minhtenlado/IoT_Gateway_STM32F407VGTx/production/bom.csv

Designator | Footprint | Quantity | Value | LCSC Part #
BT1 | BatteryHolder_Keystone_3034_1x20mm | 1 | Battery_Cell
C1, C12, C14, C15, C16, C17, C18, C19, C20, C21, C22, C25, C26, C32, C33, C36, C37, C4, C41, C42, C5, C6, C7 | 0603 | 23 | 100nF
C10, C11 | 0603 | 2 | 2.2uF
C13, C27, C62 | 0603 | 3 | 1uF
C2, C3 | 0603 | 2 | 20pF
C23, C8, C9 | 0603 | 3 | 10uF
C24 | 0603 | 1 | 470pF
C28 | 0603 | 1 | 4.7uF
C29, C30 | 0603 | 2 | 15pF
C31 | 0603 | 1 | 22nF
C34 | 0603 | 1 | 1nF
C35 | 1210 | 1 | 10uF
C38, C43, C44, C45 | 1210 | 4 | 22uF
C39 | 0805 | 1 | 10uF
C40, C59 | CP_Radial_D6.3mm_P2.50mm | 2 | 47uF
C46, C49, C50, C52, C56, C57, C58, C61 | 0805 | 8 | 100nF
C47, C51 | 1206 | 2 | 10uF
C48, C53, C60 | 0805 | 3 | 1uF
C54 | 0603 | 1 | 8.2pF
C55 | 0805 | 1 | 8.2pF
D1 | 0603 | 1 | RED
D10, D11, D8, D9 | 0805 | 4 | LED
D12 | 0805 | 1 | LED Green
D13 | 0805 | 1 | LED Red
D2 | 0603 | 1 | BLUE
D3, D4 | D_SMA | 2 | SS14
D5 | D_SMA | 1 | SS34
D6 | D_SMB | 1 | SMBJ15CA
D7 | D_SOD-323 | 1 | BAS116WS
F1 | 1206 | 1 | 2A Slow-Blow
FB1, FB2 | 0603 | 2 | FerriteBead
FB3, FB4 | 0402 | 2 | BLM15HD182SN1
J1 | PinHeader_1x05_P2.54mm_Vertical | 1 | Dùng nạp cho U3
J10 | BarrelJack_CUI_PJ-102AH_Horizontal | 1 | Power 12V
J11 | PinHeader_2x10_P2.54mm_Vertical | 1 | GPIO_D_E
J12 | PinHeader_2x10_P2.54mm_Vertical | 1 | GPIO_A_B
J13 | PinHeader_1x05_P2.54mm_Vertical | 1 | ESP32_UART0_PROG
J2 | USB_C_Receptacle_HRO_TYPE-C-31-M-12 | 1 | USB_C_Receptacle_USB2.0_16P
J3 | RJ45_Hanrun_HR911105A_Horizontal | 1 | RJ45_Hanrun_HR911105A_Horizontal
J4 | PinHeader_2x10_P2.54mm_Vertical | 1 | GPIO_B_C_D
J5 | TerminalBlock_Phoenix_MKDS-1,5-3-5.08_1x03_P5.08mm_Horizontal | 1 | Screw_Terminal_01x03
J6 | TerminalBlock_Phoenix_MKDS-3-3-5.08_1x03_P5.08mm_Horizontal | 1 | RELAY1
J7 | TerminalBlock_Phoenix_MKDS-3-3-5.08_1x03_P5.08mm_Horizontal | 1 | RELAY2
J8 | TerminalBlock_Phoenix_MKDS-3-3-5.08_1x03_P5.08mm_Horizontal | 1 | RELAY3
J9 | TerminalBlock_Phoenix_MKDS-3-3-5.08_1x03_P5.08mm_Horizontal | 1 | RELAY4
JP1, JP2, JP3-120R1, JP4-BIAS1, JP4-BIAS2 | PinHeader_1x02_P2.54mm_Vertical | 5 | Jumper_2_Open
K1, K2, K3, K4 | Relay_SPDT_SANYOU_SRD_Series_Form_C | 4 | SANYOU_SRD_Form_C
L1, L2 | L_Bourns_SRN6045TA | 2 | 4.7uH
Q1 | SOT-23 | 1 | BC849
R1, R2 | 0603 | 2 | 100k
R10, R6 | 0603 | 2 | 100R
R11, R14, R15, R18, R19, R20, R21, R24, R25, R26, R27, R3 | 0603 | 12 | 10K
R12 | 0603 | 1 | 39K
R13 | 0603 | 1 | 1K5
R16, R17 | 0603 | 2 | 5.1K
R22 | 0603 | 1 | 12.1K
R23 | 0603 | 1 | 33R
R28, R29 | 0603 | 2 | 330R
R30, R31, R32, R33 | 0603 | 4 | 49.9R
R34 | 0603 | 1 | 1.5K
R35 | 0603 | 1 | 1MR
R36, R40, R41, R42, R55, R57 | 0805 | 6 | 10K
R37 | 1206 | 1 | 120R
R38, R39 | 0805 | 2 | 330R
R4 | 0603 | 1 | DNP
R43 | 0805 | 1 | 22R
R44, R45, R46, R47 | 0805 | 4 | 100K
R48, R49, R50, R51, R52, R53, R54 | 0805 | 7 | 4.7K
R5, R7 | 0603 | 2 | 4K7
R56 | 2512 | 1 | 20mR
R58 | 0805 | 1 | 1K
R8 | 0603 | 1 | 200R
R9 | 0603 | 1 | 220R
S1, S2 | SW_TS-1187A-B-A-B | 2 | TS-1187A-B-A-B
SW1 | SW_PUSH-12mm | 1 | SW_Push
SW2 | SW_Slide_SPDT_Straight_CK_OS102011MS2Q | 1 | SW_SPDT
TP1, TP2, TP3 | TestPoint_Pad_D1.5mm | 3 | TestPoint
U1 | LQFP-48_7x7mm_P0.5mm | 1 | STM32F103CBTx
U10 | RN-28-1_ADI-L | 1 | ADM2861EBRNZ
U11 | SOIC-16_3.9x9.9mm_P1.27mm | 1 | ULN2003A
U12 | SO-8_3.9x4.9mm_P1.27mm | 1 | TMP1075D
U13 | TSSOP-10_3x3mm_P0.5mm | 1 | INA226
U14 | ESP32-C3-WROOM-02U | 1 | ESP32-C3-WROOM-02U
U2 | SOT-23-6 | 1 | USBLC6-2SC6
U3 | LQFP-100_14x14mm_P0.5mm | 1 | STM32F407VGTx
U4 | SOIC-8_5.3x5.3mm_P1.27mm | 1 | W25Q128JVS
U6 | VQFN-24-1EP_4x4mm_P0.5mm_EP2.5x2.5mm_ThermalVias | 1 | LAN8720A
U7 | TSOT-23-6 | 1 | AP63203WU
U8 | TSOT-23-6 | 1 | AP63205WU
U9 | SOT-23-5 | 1 | AP2112K-3.3
Y1 | Crystal_SMD_ECS_CSM3X-2Pin_7.6x4.1mm | 1 | Crystal
Y2 | Crystal_SMD_3225-4Pin_3.2x2.5mm | 1 | 25MHz
Y3 | Crystal_SMD_3215-2Pin_3.2x1.5mm | 1 | FC-135
