minhtenlado/IoT_Gateway_STM32F407VGTx/schematic.pdf

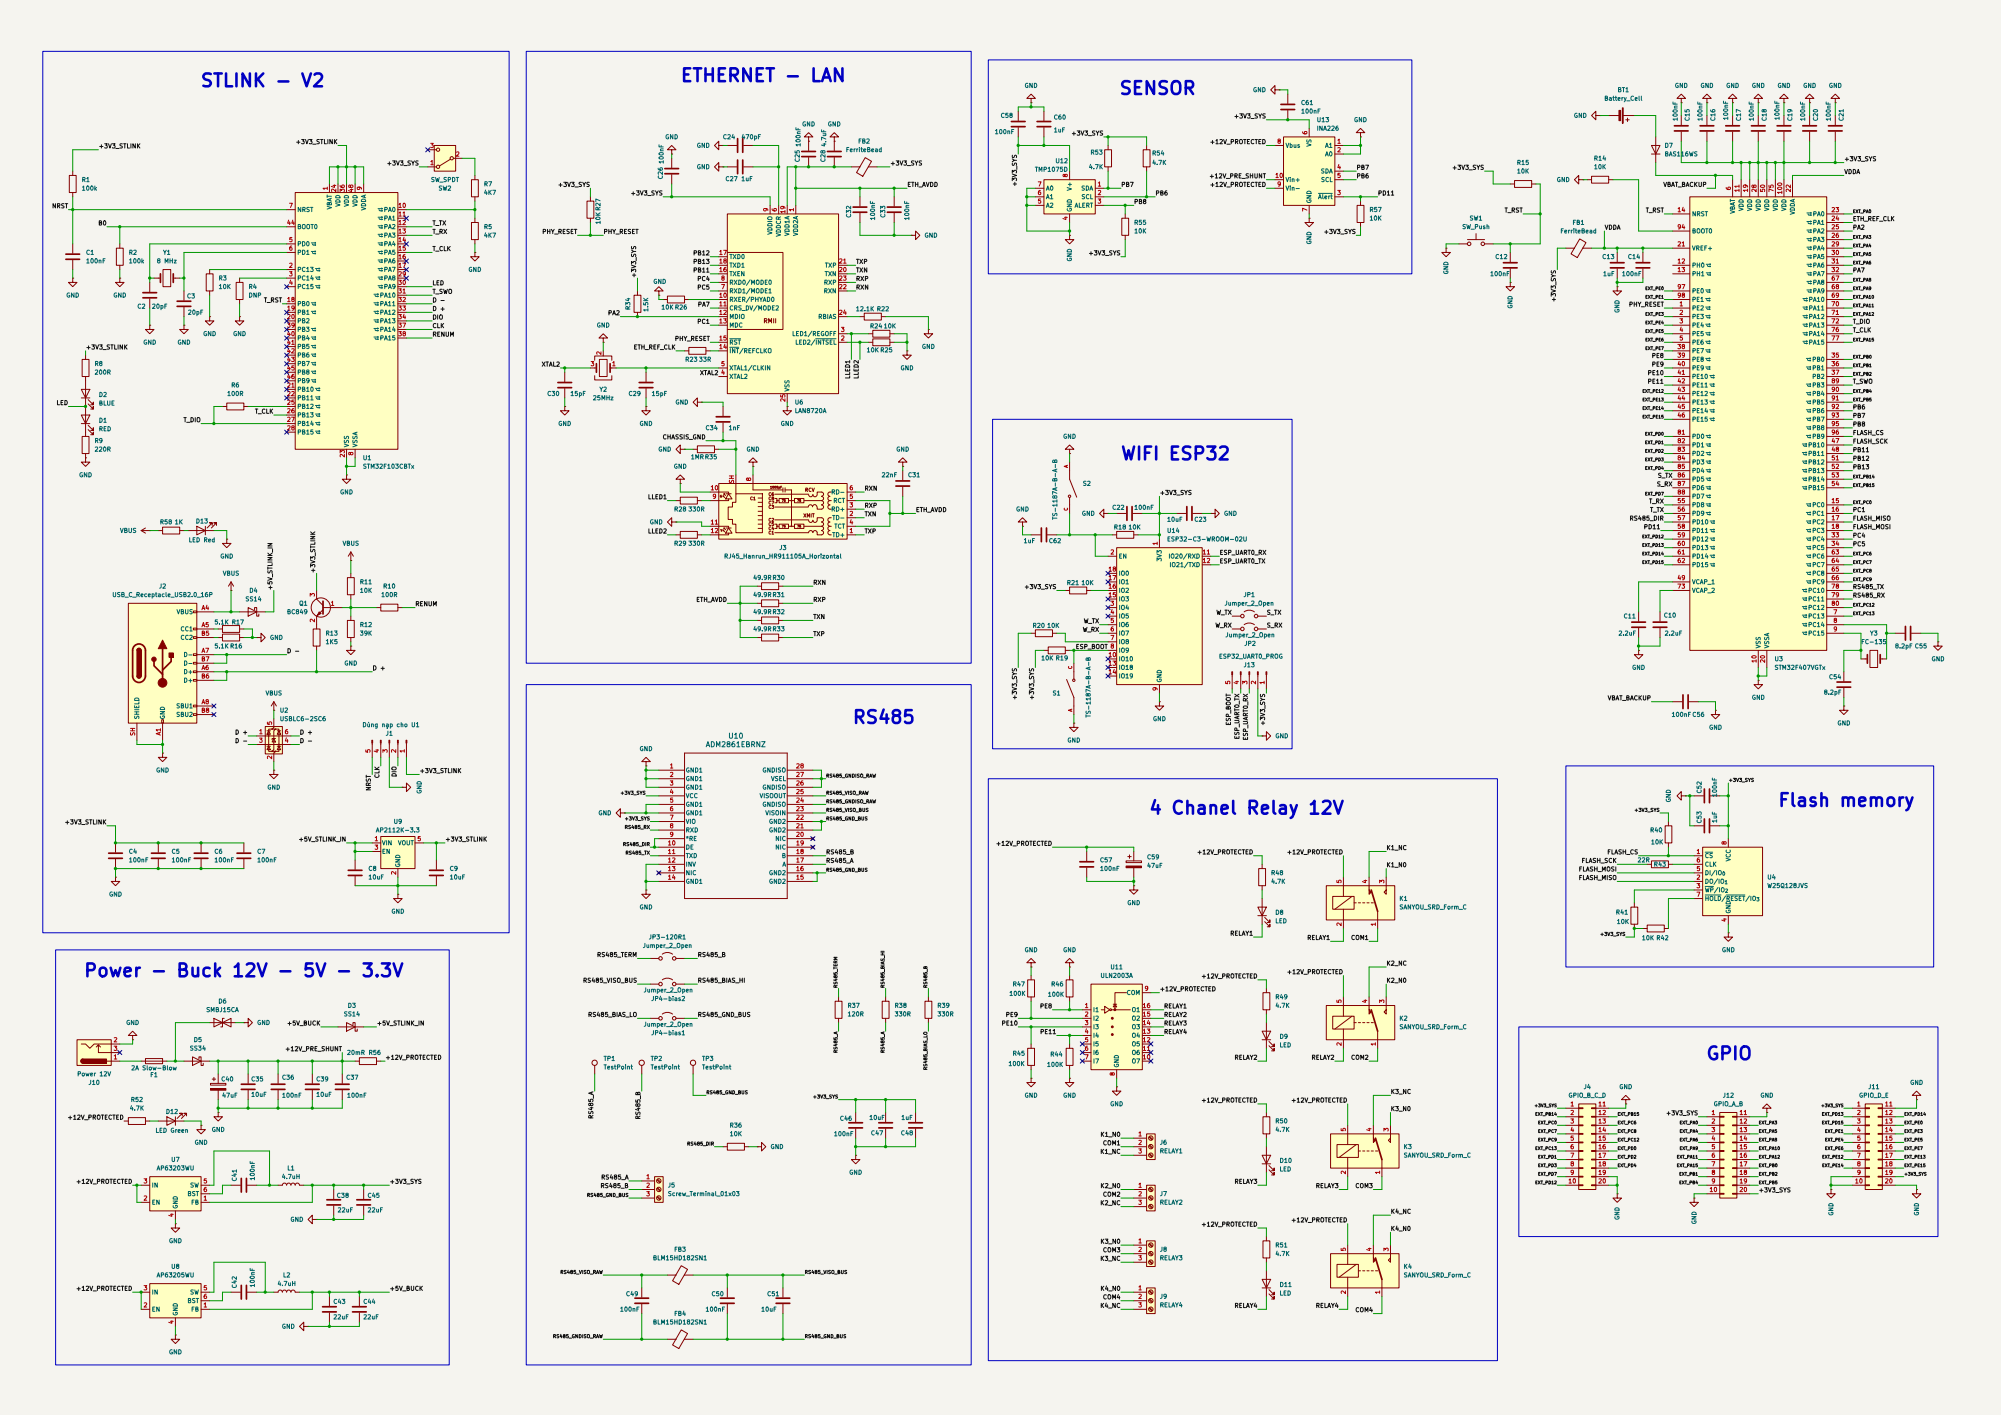
[picture p12: page 1]
