minhtenlado/IoT_Gateway_STM32F407VGTx/IoT_gateway_STM32F407.kicad_pcb

## KiCad design IoT_gateway_STM32F407.kicad_pcb (2026-11-01)

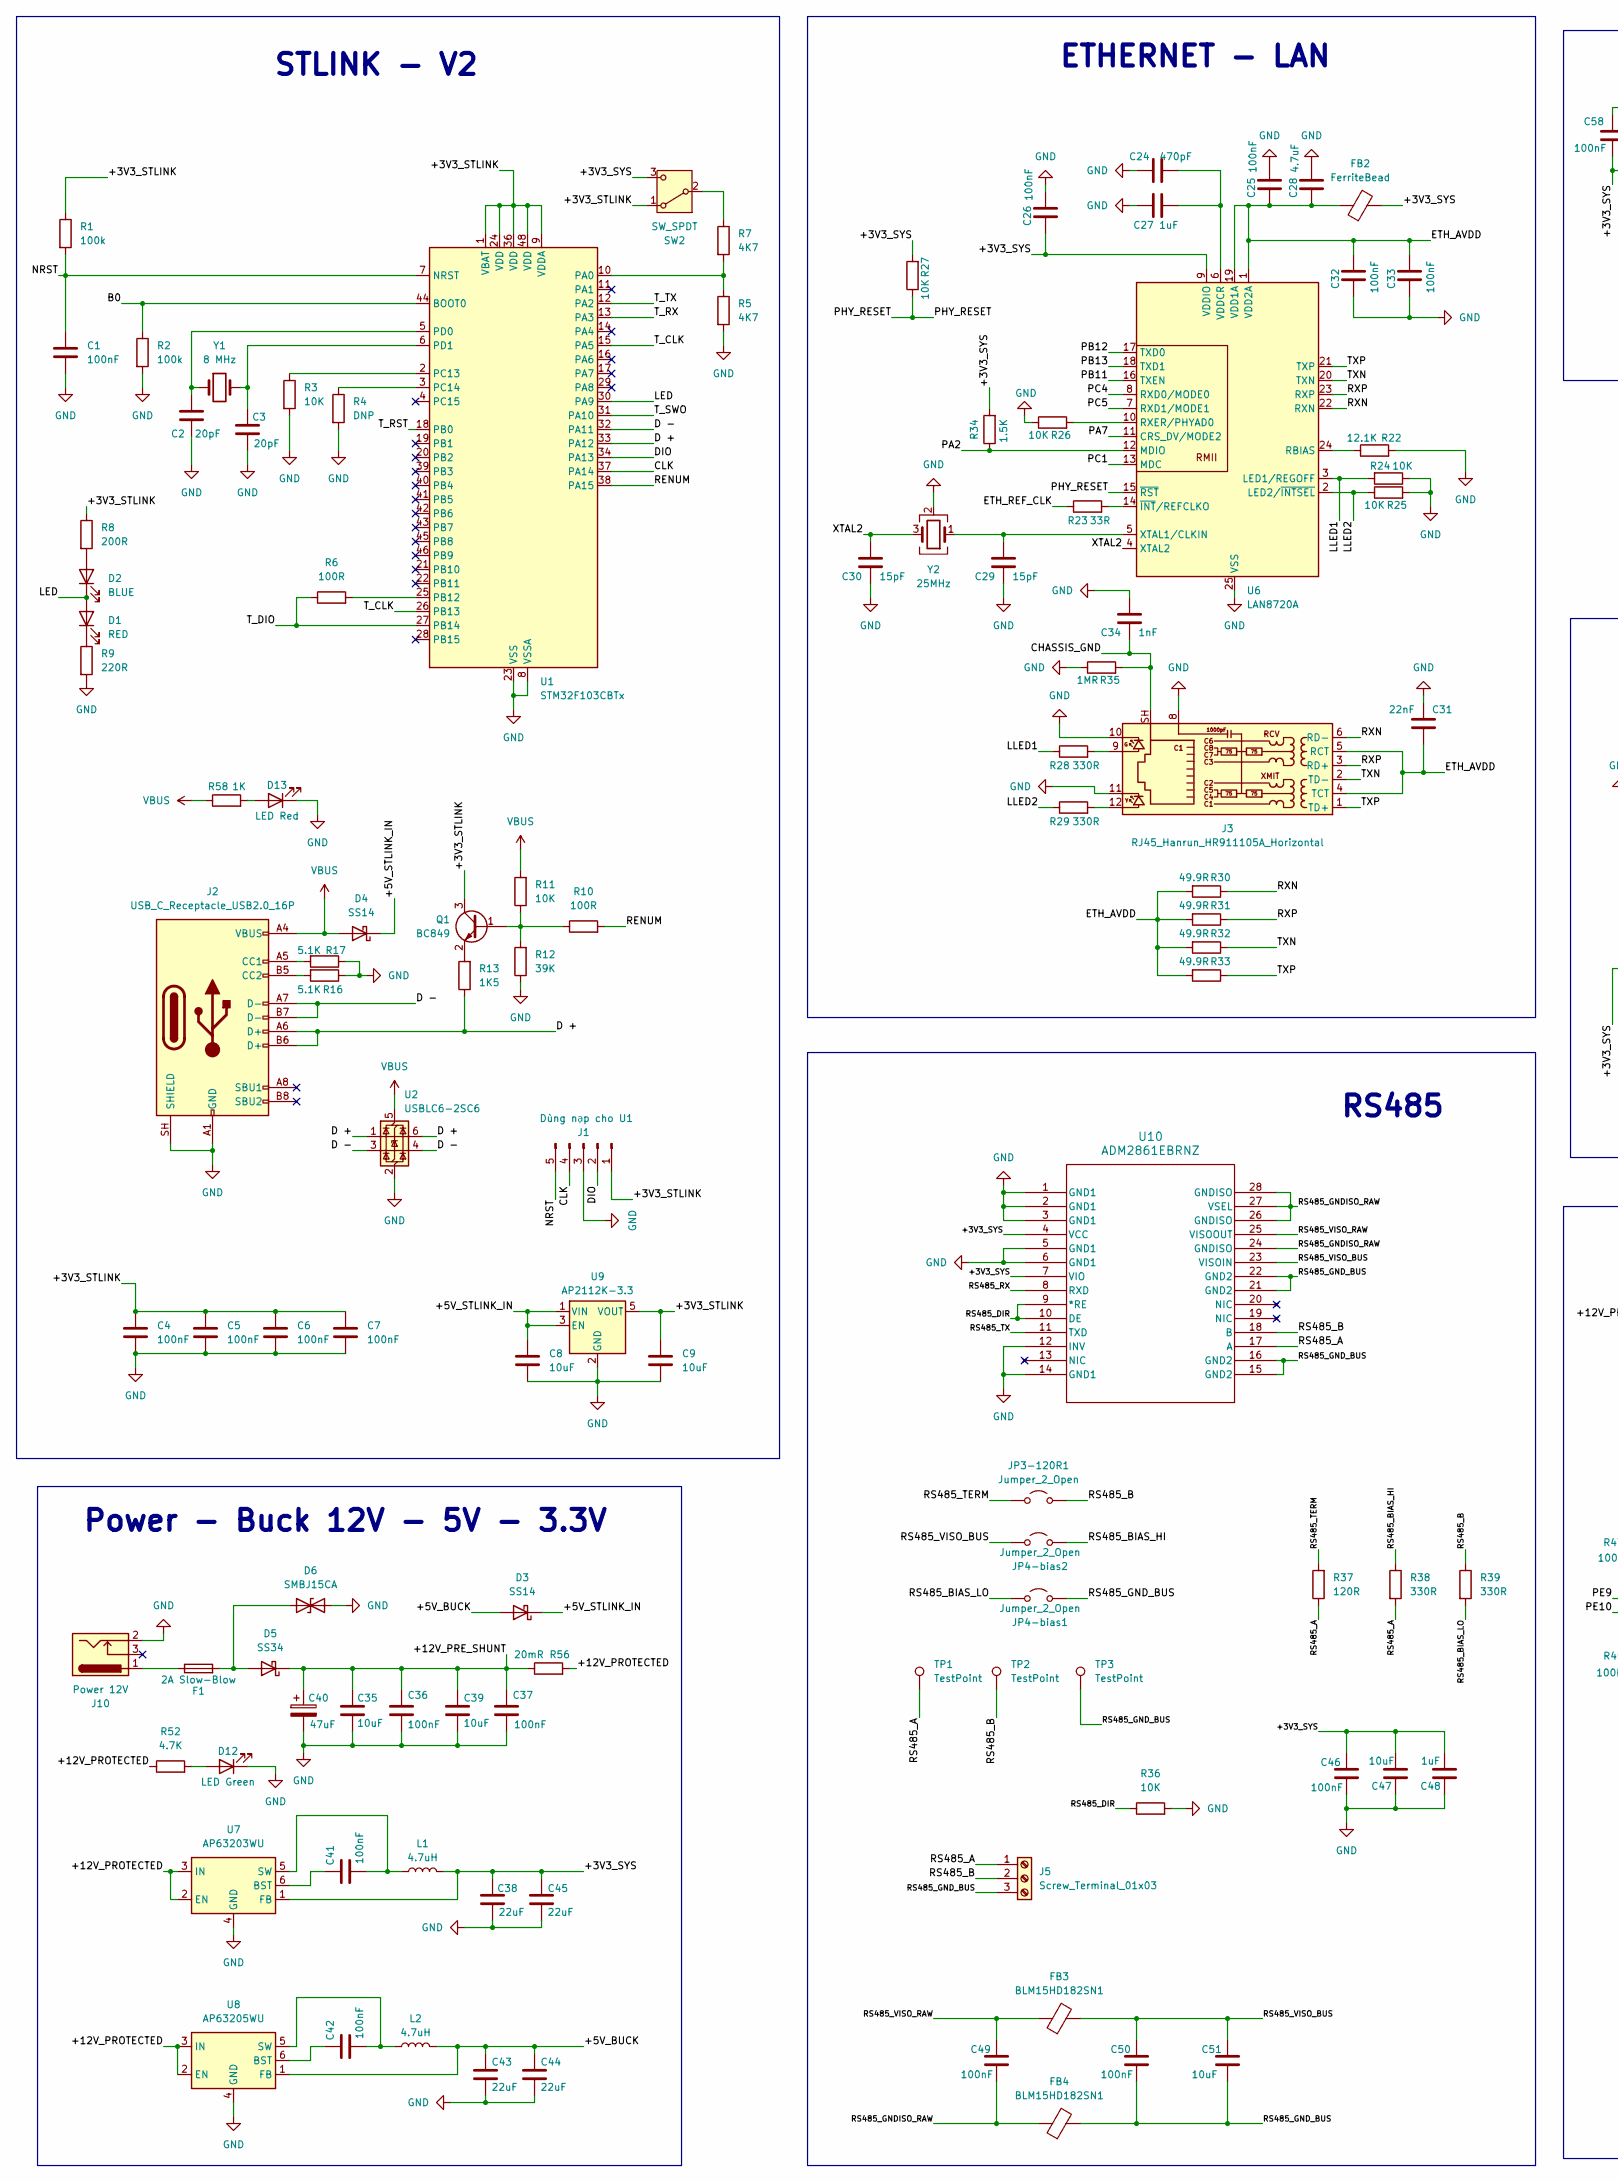
[picture p13: schematic IoT_gateway_STM32F407.kicad_sch, Phan Huynh Van Do, part in row 1, column 1]

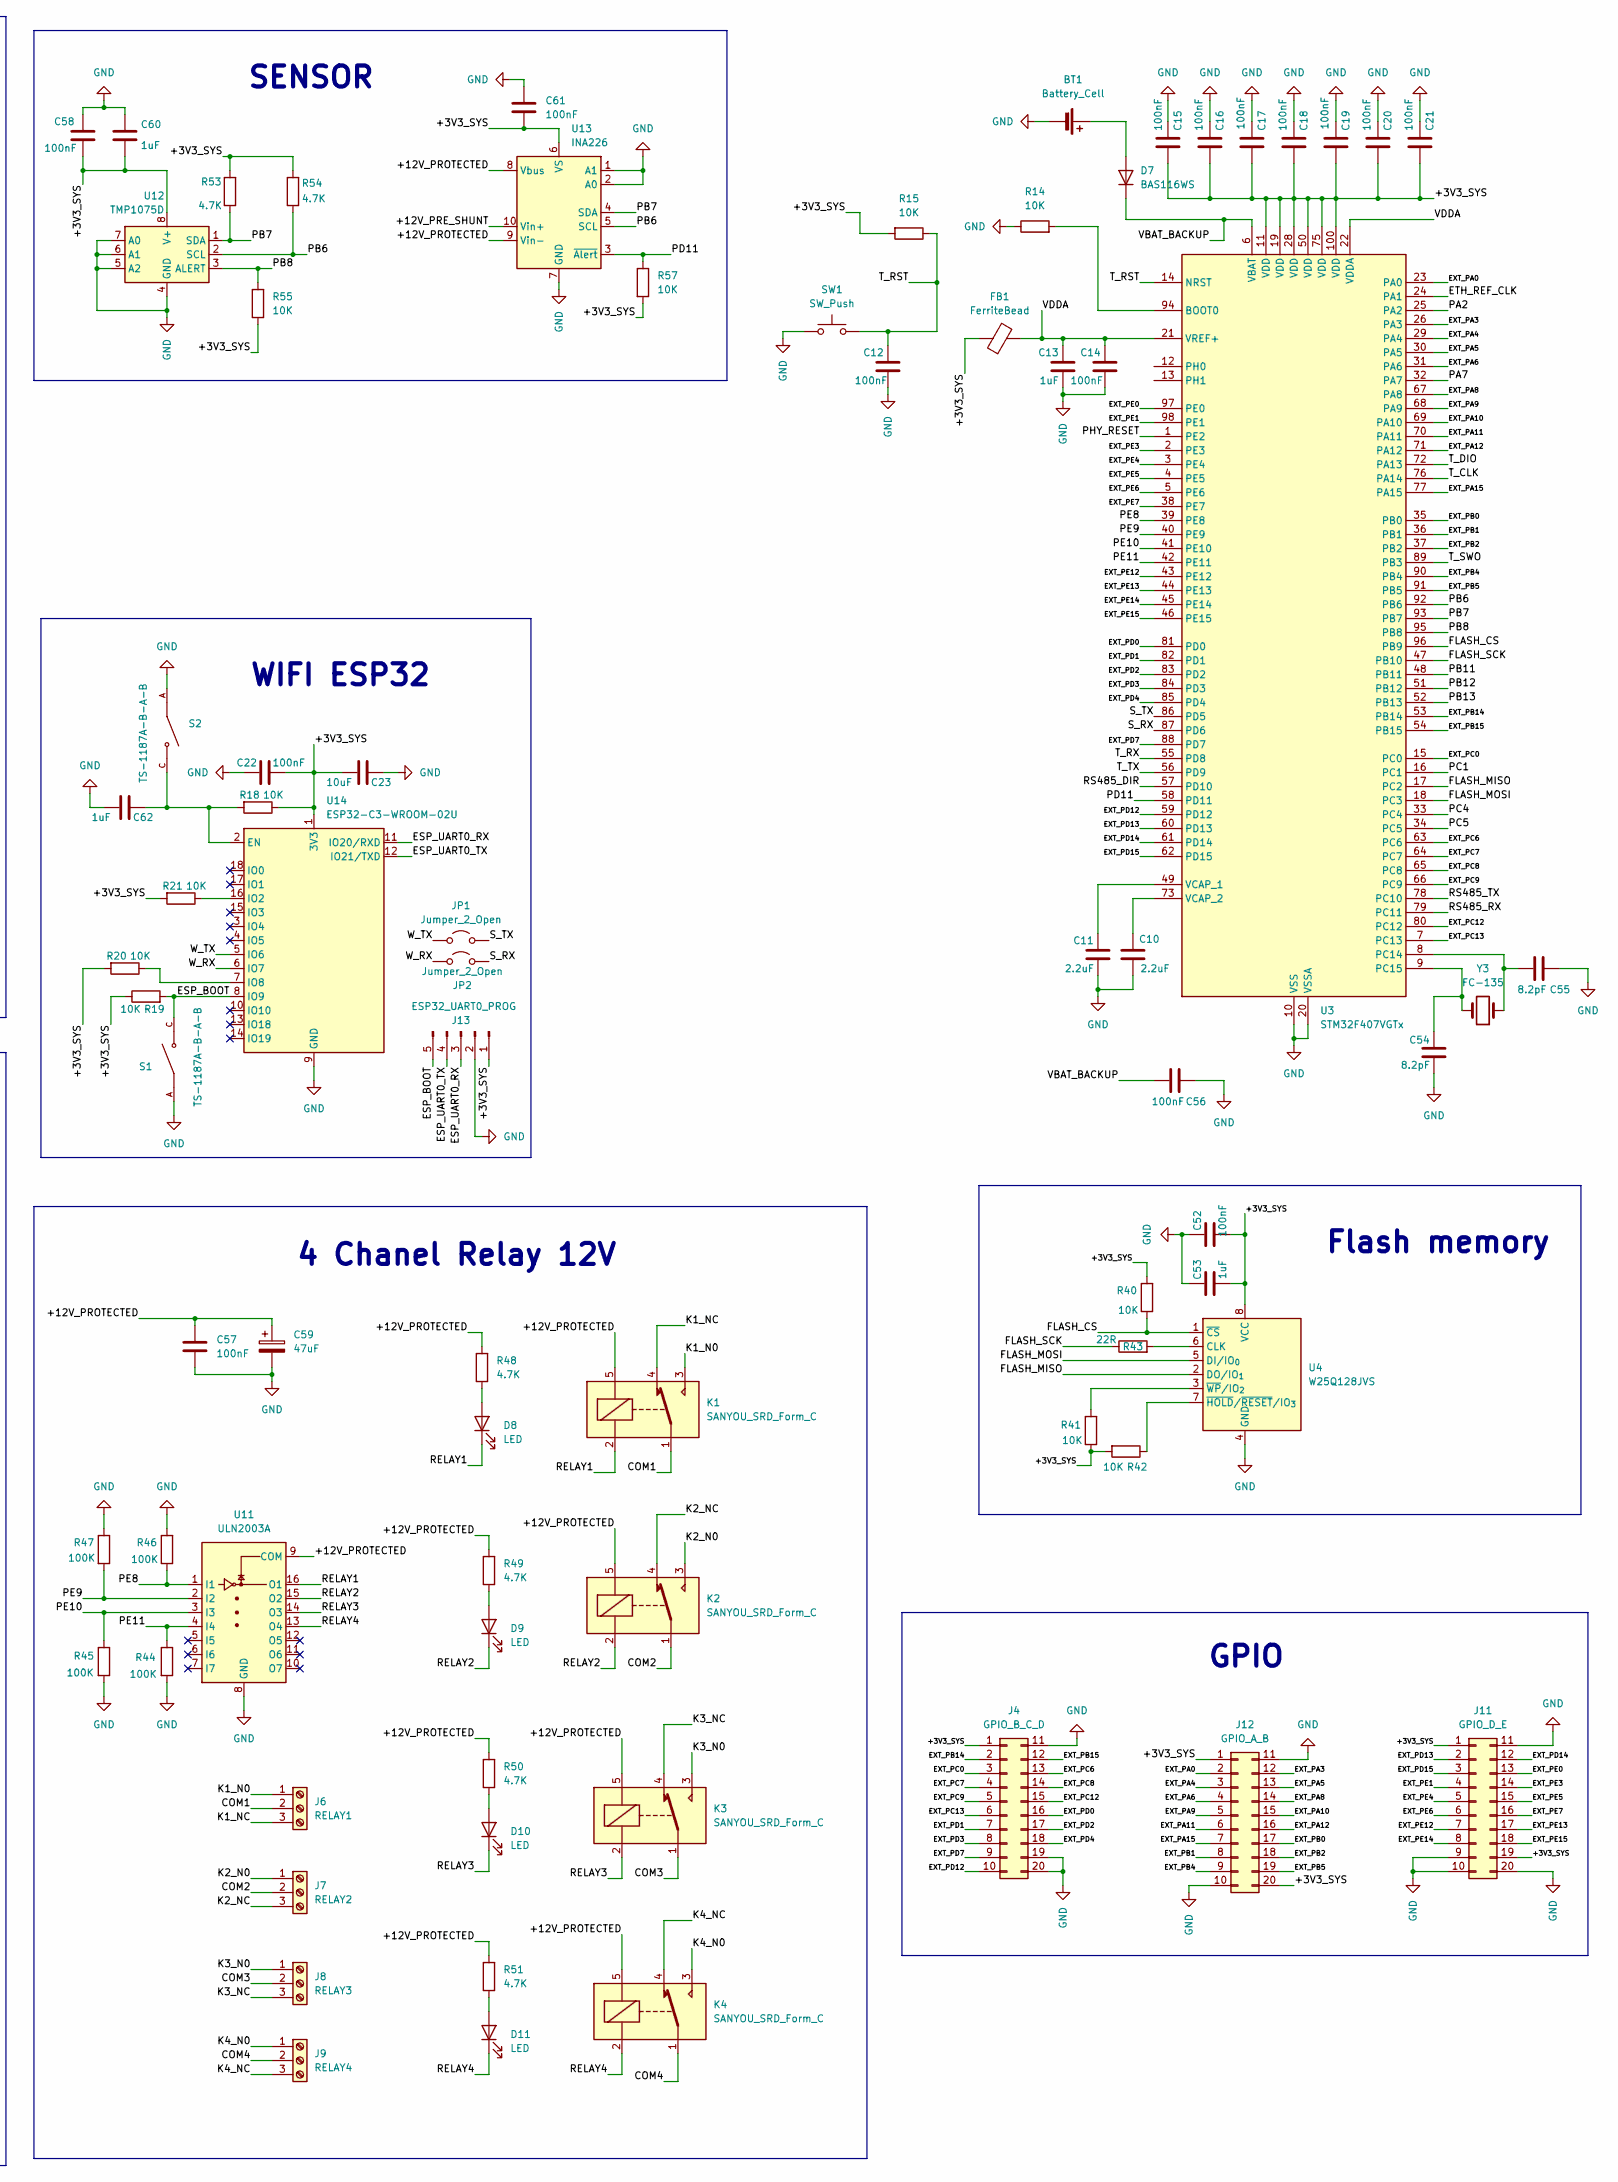
[picture p14: schematic IoT_gateway_STM32F407.kicad_sch, Phan Huynh Van Do, part in row 1, column 2]

Parts:
BT1: Battery_Cell; BatteryHolder_Keystone_3034_1x20mm
C1, C4, C5, C6, C7, C12, C14, C15, C16, C17, C18, C19, C20, C21, C22, C25, C26, C32, C33, C36, C37, C41, C42: 100nF; C_0603_1608Metric
C2, C3: 20pF; C_0603_1608Metric
C8, C9, C23: 10uF; C_0603_1608Metric
C10, C11: 2.2uF; C_0603_1608Metric
C13, C27, C62: 1uF; C_0603_1608Metric
C24: 470pF; C_0603_1608Metric
C28: 4.7uF; C_0603_1608Metric
C29, C30: 15pF; C_0603_1608Metric
C31: 22nF; C_0603_1608Metric
C34: 1nF; C_0603_1608Metric
C35: 10uF; C_1210_3225Metric
C38, C43, C44, C45: 22uF; C_1210_3225Metric
C39: 10uF; C_0805_2012Metric
C40, C59: 47uF; CP_Radial_D6.3mm_P2.50mm
C46, C49, C50, C52, C56, C57, C58, C61: 100nF; C_0805_2012Metric
C47, C51: 10uF; C_1206_3216Metric
C48, C53, C60: 1uF; C_0805_2012Metric
C54: 8.2pF; C_0603_1608Metric
C55: 8.2pF; C_0805_2012Metric
D1: RED; LED_0603_1608Metric
D2: BLUE; LED_0603_1608Metric
D3, D4: SS14; D_SMA
D5: SS34; D_SMA
D6: SMBJ15CA; D_SMB
D7: BAS116WS; D_SOD-323
D8, D9, D10, D11: LED; LED_0805_2012Metric
D12: LED Green; LED_0805_2012Metric
D13: LED Red; LED_0805_2012Metric
F1: 2A Slow-Blow; Fuse_1206_3216Metric
FB1, FB2: FerriteBead; L_0603_1608Metric
FB3, FB4: BLM15HD182SN1; L_0402_1005Metric
J1: Dùng nạp cho U1; PinHeader_1x05_P2.54mm_Vertical
J2: USB_C_Receptacle_USB2.0_16P; USB_C_Receptacle_HRO_TYPE-C-31-M-12
J3: RJ45_Hanrun_HR911105A_Horizontal
J4: GPIO_B_C_D; PinHeader_2x10_P2.54mm_Vertical
J5: Screw_Terminal_01x03; TerminalBlock_Phoenix_MKDS-1,5-3-5.08_1x03_P5.08mm_Horizont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
J6: RELAY1; TerminalBlock_Phoenix_MKDS-3-3-5.08_1x03_P5.08mm_Horizontal
J7: RELAY2; TerminalBlock_Phoenix_MKDS-3-3-5.08_1x03_P5.08mm_Horizontal
J8: RELAY3; TerminalBlock_Phoenix_MKDS-3-3-5.08_1x03_P5.08mm_Horizontal
J9: RELAY4; TerminalBlock_Phoenix_MKDS-3-3-5.08_1x03_P5.08mm_Horizontal
J10: Power 12V; BarrelJack_CUI_PJ-102AH_Horizontal
J11: GPIO_D_E; PinHeader_2x10_P2.54mm_Vertical
J12: GPIO_A_B; PinHeader_2x10_P2.54mm_Vertical
J13: ESP32_UART0_PROG; PinHeader_1x05_P2.54mm_Vertical
JP1, JP2, JP3-120R1, JP4-bias1, JP4-bias2: Jumper_2_Open; PinHeader_1x02_P2.54mm_Vertical
K1, K2, K3, K4: SANYOU_SRD_Form_C; Relay_SPDT_SANYOU_SRD_Series_Form_C
L1, L2: 4.7uH; L_Bourns_SRN6045TA
Q1: BC849; SOT-23
R1, R2: 100k; R_0603_1608Metric
R3, R11, R14, R15, R18, R19, R20, R21, R24, R25, R26, R27: 10K; R_0603_1608Metric
R4: DNP; R_0603_1608Metric
R5, R7: 4K7; R_0603_1608Metric
R6, R10: 100R; R_0603_1608Metric
R8: 200R; R_0603_1608Metric
R9: 220R; R_0603_1608Metric
R12: 39K; R_0603_1608Metric
R13: 1K5; R_0603_1608Metric
R16, R17: 5.1K; R_0603_1608Metric
R22: 12.1K; R_0603_1608Metric
R23: 33R; R_0603_1608Metric
R28, R29: 330R; R_0603_1608Metric
R30, R31, R32, R33: 49.9R; R_0603_1608Metric
R34: 1.5K; R_0603_1608Metric
R35: 1MR; R_0603_1608Metric
R36, R40, R41, R42, R55, R57: 10K; R_0805_2012Metric
R37: 120R; R_1206_3216Metric
R38, R39: 330R; R_0805_2012Metric
R43: 22R; R_0805_2012Metric
R44, R45, R46, R47: 100K; R_0805_2012Metric
R48, R49, R50, R51, R52, R53, R54: 4.7K; R_0805_2012Metric
R56: 20mR; R_2512_6332Metric
R58: 1K; R_0805_2012Metric
S1, S2: TS-1187A-B-A-B; SW_TS-1187A-B-A-B; PARTREV A0
SW1: SW_Push; SW_PUSH-12mm
SW2: SW_SPDT; SW_Slide_SPDT_Straight_CK_OS102011MS2Q
TP1, TP2, TP3: TestPoint; TestPoint_Pad_D1.5mm
U1: STM32F103CBTx; LQFP-48_7x7mm_P0.5mm
U2: USBLC6-2SC6; SOT-23-6
U3: STM32F407VGTx; LQFP-100_14x14mm_P0.5mm
U4: W25Q128JVS; SOIC-8_5.3x5.3mm_P1.27mm
U6: LAN8720A; VQFN-24-1EP_4x4mm_P0.5mm_EP2.5x2.5mm_ThermalVias
U7: AP63203WU; TSOT-23-6
U8: AP63205WU; TSOT-23-6
U9: AP2112K-3.3; SOT-23-5
U10: ADM2861EBRNZ; RN-28-1_ADI-L
U11: ULN2003A; SOIC-16_3.9x9.9mm_P1.27mm
U12: TMP1075D; SO-8_3.9x4.9mm_P1.27mm
U13: INA226; TSSOP-10_3x3mm_P0.5mm
U14: ESP32-C3-WROOM-02U
Y1: 8 MHz; Crystal_SMD_ECS_CSM3X-2Pin_7.6x4.1mm
Y2: 25MHz; Crystal_SMD_3225-4Pin_3.2x2.5mm
Y3: FC-135; Crystal_SMD_3215-2Pin_3.2x1.5mm

Connections:
/+3V3_STLINK: C4.2, C5.2, C6.2, C7.2, C9.2, J1.1, Q1.3 (C), R1.1, R8.1, SW2.1 (A), U1.1 (VBAT), U1.9 (VDDA), U1.24 (VDD), U1.36 (VDD), U1.48 (VDD), U9.5 (VOUT)
/+3V3_SYS: C15.2, C16.2, C17.2, C18.2, C19.2, C20.2, C21.2, C22.1, C23.1, C26.1, C38.1, C45.1, C46.1, C47.2, C48.2, C52.2, C53.2, C58.2, C60.2, C61.2, FB1.1, FB2.2, J4.1, J11.1, J11.19, J12.1, J12.20, J13.1, L1.2, R15.2, R18.1, R19.1, R20.2, R21.2, R27.2, R34.2, R40.2, R41.1, R42.2, R53.2, R54.2, R55.1, R57.2, SW2.3 (C), U3.11 (VDD), U3.19 (VDD), U3.28 (VDD), U3.50 (VDD), U3.75 (VDD), U3.100 (VDD), U4.8 (VCC), U6.9 (VDDIO), U7.1 (FB), U10.4 (VCC), U10.7 (VIO), U12.8 (V+), U13.6 (VS), U14.1 (3V3)
/+5V_BUCK: C43.1, C44.1, D3.2 (A), L2.2, U8.1 (FB)
/+5V_STLINK_IN: C8.2, D3.1 (K), D4.1 (K), U9.1 (VIN), U9.3 (EN)
/+12V_PRE_SHUNT: C35.1, C36.1, C37.1, C39.1, C40.1, D5.1 (K), R56.1, U13.10 (Vin+)
/+12V_PROTECTED: C57.1, C59.1, K1.5, K2.5, K3.5, K4.5, R48.2, R49.2, R50.2, R51.2, R52.1, R56.2, U7.2 (EN), U7.3 (IN), U8.2 (EN), U8.3 (IN), U11.9 (COM), U13.8 (Vbus), U13.9 (Vin-)
/B0: R2.1, U1.44 (BOOT0)
/CHASSIS_GND: C34.1, J3.SH, R35.2
/CLK: J1.4, U1.37 (PA14)
/COM1: J6.2, K1.1
/COM2: J7.2, K2.1
/COM3: J8.2, K3.1
/COM4: J9.2, K4.1
/D +: J2.A6 (D+), J2.B6 (D+), R13.1, U1.33 (PA12), U2.1 (I/O1), U2.6 (I/O1)
/D -: J2.A7 (D-), J2.B7 (D-), U1.32 (PA11), U2.3 (I/O2), U2.4 (I/O2)
/DIO: J1.2, U1.34 (PA13)
/ESP_BOOT: J13.5, R19.2, S1.C, S1.D, U14.8 (IO9)
/ESP_UART0_RX: J13.3, U14.11 (IO20/RXD)
/ESP_UART0_TX: J13.4, U14.12 (IO21/TXD)
/ETH_AVDD: C25.1, C28.1, C31.2, C32.2, C33.2, FB2.1, J3.4 (TCT), J3.5 (RCT), R30.2, R31.2, R32.2, R33.2, U6.1 (VDD2A), U6.19 (VDD1A)
/ETH_REF_CLK: R23.1, U3.24 (PA1)
/EXT_PA0: J12.2, U3.23 (PA0)
/EXT_PA3: J12.12, U3.26 (PA3)
/EXT_PA4: J12.3, U3.29 (PA4)
/EXT_PA5: J12.13, U3.30 (PA5)
/EXT_PA6: J12.4, U3.31 (PA6)
/EXT_PA8: J12.14, U3.67 (PA8)
/EXT_PA9: J12.5, U3.68 (PA9)
/EXT_PA10: J12.15, U3.69 (PA10)
/EXT_PA11: J12.6, U3.70 (PA11)
/EXT_PA12: J12.16, U3.71 (PA12)
/EXT_PA15: J12.7, U3.77 (PA15)
/EXT_PB0: J12.17, U3.35 (PB0)
/EXT_PB1: J12.8, U3.36 (PB1)
/EXT_PB2: J12.18, U3.37 (PB2)
/EXT_PB4: J12.9, U3.90 (PB4)
/EXT_PB5: J12.19, U3.91 (PB5)
/EXT_PB14: J4.2, U3.53 (PB14)
/EXT_PB15: J4.12, U3.54 (PB15)
/EXT_PC0: J4.3, U3.15 (PC0)
/EXT_PC6: J4.13, U3.63 (PC6)
/EXT_PC7: J4.4, U3.64 (PC7)
/EXT_PC8: J4.14, U3.65 (PC8)
/EXT_PC9: J4.5, U3.66 (PC9)
/EXT_PC12: J4.15, U3.80 (PC12)
/EXT_PC13: J4.6, U3.7 (PC13)
/EXT_PD0: J4.16, U3.81 (PD0)
/EXT_PD1: J4.7, U3.82 (PD1)
/EXT_PD2: J4.17, U3.83 (PD2)
/EXT_PD3: J4.8, U3.84 (PD3)
/EXT_PD4: J4.18, U3.85 (PD4)
/EXT_PD7: J4.9, U3.88 (PD7)
/EXT_PD12: J4.10, U3.59 (PD12)
/EXT_PD13: J11.2, U3.60 (PD13)
/EXT_PD14: J11.12, U3.61 (PD14)
/EXT_PD15: J11.3, U3.62 (PD15)
/EXT_PE0: J11.13, U3.97 (PE0)
/EXT_PE1: J11.4, U3.98 (PE1)
/EXT_PE3: J11.14, U3.2 (PE3)
/EXT_PE4: J11.5, U3.3 (PE4)
/EXT_PE5: J11.15, U3.4 (PE5)
/EXT_PE6: J11.6, U3.5 (PE6)
/EXT_PE7: J11.16, U3.38 (PE7)
/EXT_PE12: J11.7, U3.43 (PE12)
/EXT_PE13: J11.17, U3.44 (PE13)
/EXT_PE14: J11.8, U3.45 (PE14)
/EXT_PE15: J11.18, U3.46 (PE15)
/FLASH_CS: R40.1, U3.96 (PB9), U4.1 (~CS)
/FLASH_MISO: U3.17 (PC2), U4.2 (DO/IO_{1})
/FLASH_MOSI: U3.18 (PC3), U4.5 (DI/IO_{0})
/FLASH_SCK: R43.1, U3.47 (PB10)
/K1_N0: J6.1, K1.3
/K1_NC: J6.3, K1.4
/K2_N0: J7.1, K2.3
/K2_NC: J7.3, K2.4
/K3_N0: J8.1, K3.3
/K3_NC: J8.3, K3.4
/K4_N0: J9.1, K4.3
/K4_NC: J9.3, K4.4
/LED: D1.2 (A), D2.1 (K), U1.30 (PA9)
/LLED1: R24.2, R28.1, U6.3 (LED1/REGOFF)
/LLED2: R25.1, R29.1, U6.2 (LED2/~INTSEL)
/NRST: C1.1, J1.5, R1.2, U1.7 (NRST)
/PA2: R34.1, U3.25 (PA2), U6.12 (MDIO)
/PA7: U3.32 (PA7), U6.11 (CRS_DV/MODE2)
/PB6: R54.1, U3.92 (PB6), U12.2 (SCL), U13.5 (SCL)
/PB7: R53.1, U3.93 (PB7), U12.1 (SDA), U13.4 (SDA)
/PB8: R55.2, U3.95 (PB8), U12.3 (ALERT)
/PB11: U3.48 (PB11), U6.16 (TXEN)
/PB12: U3.51 (PB12), U6.17 (TXD0)
/PB13: U3.52 (PB13), U6.18 (TXD1)
/PC1: U3.16 (PC1), U6.13 (MDC)
/PC4: U3.33 (PC4), U6.8 (RXD0/MODE0)
/PC5: U3.34 (PC5), U6.7 (RXD1/MODE1)
/PD11: R57.1, U3.58 (PD11), U13.3 (~Alert)
/PE8: R46.1, U3.39 (PE8), U11.1 (I1)
/PE9: R47.2, U3.40 (PE9), U11.2 (I2)
/PE10: R45.1, U3.41 (PE10), U11.3 (I3)
/PE11: R44.1, U3.42 (PE11), U11.4 (I4)
/PHY_RESET: R27.1, U3.1 (PE2), U6.15 (~RST)
/RELAY1: D8.1 (K), K1.2, U11.16 (O1)
/RELAY2: D9.1 (K), K2.2, U11.15 (O2)
/RELAY3: D10.1 (K), K3.2, U11.14 (O3)
/RELAY4: D11.1 (K), K4.2, U11.13 (O4)
/RENUM: R10.2, U1.38 (PA15)
/RS485_A: J5.1, R37.1, R38.2, TP1.1 (1_1), U10.17 (A)
/RS485_B: J5.2, JP3-120R1.2 (B), R39.1, TP2.1 (1_1), U10.18 (B)
/RS485_BIAS_HI: JP4-bias2.2 (B), R38.1
/RS485_BIAS_LO: JP4-bias1.1 (A), R39.2
/RS485_DIR: R36.1, U3.57 (PD10), U10.9 (*RE), U10.10 (DE)
/RS485_GNDISO_RAW: C49.2, FB4.1, U10.24 (GNDISO), U10.26 (GNDISO), U10.27 (VSEL), U10.28 (GNDISO)
/RS485_GND_BUS: C50.2, C51.2, FB4.2, J5.3, JP4-bias1.2 (B), TP3.1 (1_1), U10.15 (GND2), U10.16 (GND2), U10.21 (GND2), U10.22 (GND2)
/RS485_RX: U3.79 (PC11), U10.8 (RXD)
/RS485_TERM: JP3-120R1.1 (A), R37.2
/RS485_TX: U3.78 (PC10), U10.11 (TXD)
/RS485_VISO_BUS: C50.1, C51.1, FB3.2, JP4-bias2.1 (A), U10.23 (VISOIN)
/RS485_VISO_RAW: C49.1, FB3.1, U10.25 (VISOOUT)
/RXN: J3.6 (RD-), R30.1, U6.22 (RXN)
/RXP: J3.3 (RD+), R31.1, U6.23 (RXP)
/S_RX: JP2.2 (B), U3.87 (PD6)
/S_TX: JP1.2 (B), U3.86 (PD5)
/TXN: J3.2 (TD-), R32.1, U6.20 (TXN)
/TXP: J3.1 (TD+), R33.1, U6.21 (TXP)
/T_CLK: U1.15 (PA5), U1.26 (PB13), U3.76 (PA14)
/T_DIO: R6.1, U1.27 (PB14), U3.72 (PA13)
/T_RST: C12.1, R15.1, SW1.2, U1.18 (PB0), U3.14 (NRST)
/T_RX: U1.13 (PA3), U3.55 (PD8)
/T_SWO: U1.31 (PA10), U3.89 (PB3)
/T_TX: U1.12 (PA2), U3.56 (PD9)
/VBAT_BACKUP: C56.2, D7.1 (K), U3.6 (VBAT)
/VDDA: C13.1, C14.1, FB1.2, U3.21 (VREF+), U3.22 (VDDA)
/W_RX: JP2.1 (A), U14.6 (IO7)
/W_TX: JP1.1 (A), U14.5 (IO6)
/XTAL2: C30.2, U6.4 (XTAL2), Y2.3
GND: BT1.2 (-), C1.2, C2.2, C3.2, C4.1, C5.1, C6.1, C7.1, C8.1, C9.1, C10.2, C11.2, C12.2, C13.2, C14.2, C15.1, C16.1, C17.1, C18.1, C19.1, C20.1, C21.1, C22.2, C23.2, C24.1, C25.2, C26.2, C27.1, C28.2, C29.1, C30.1, C31.1, C32.1, C33.1, C34.2, C35.2, C36.2, C37.2, C38.2, C39.2, C40.2, C43.2, C44.2, C45.2, C46.2, C47.1, C48.1, C52.1, C53.1, C54.2, C55.1, C56.1, C57.2, C58.1, C59.2, C60.1, C61.1, C62.1, D6.2 (A2), D12.1 (K), D13.1 (K), J1.3, J2.A1 (GND), J2.A12 (GND), J2.B1 (GND), J2.B12 (GND), J2.SH (SHIELD), J3.8, J3.10, J3.11, J4.11, J4.19, J4.20, J10.2, J11.9, J11.10, J11.11, J11.20, J12.10, J12.11, J13.2, R2.2, R3.2, R4.2, R5.2, R9.2, R12.1, R14.1, R16.1, R17.1, R22.2, R24.1, R25.2, R26.1, R35.1, R36.2, R44.2, R45.2, R46.2, R47.1, S1.A, S1.B, S2.A, S2.B, SW1.1, U1.8 (VSSA), U1.23 (VSS), U1.35 (VSS), U1.47 (VSS), U2.2 (GND), U3.10 (VSS), U3.20 (VSSA), U3.27 (VSS), U3.74 (VSS), U3.99 (VSS), U4.4 (GND), U6.25 (VSS), U7.4 (GND), U8.4 (GND), U9.2 (GND), U10.1 (GND1), U10.2 (GND1), U10.3 (GND1), U10.5 (GND1), U10.6 (GND1), U10.12 (INV), U10.14 (GND1), U11.8 (GND), U12.4 (GND), U12.5 (A2), U12.6 (A1), U12.7 (A0), U13.1 (A1), U13.2 (A0), U13.7 (GND), U14.9 (GND), U14.19 (GND), Y2.2 (G), Y2.4 (G)
unnamed: BT1.1 (+), D7.2 (A)
unnamed: D1.1 (K), R9.1
unnamed: D2.2 (A), R8.2
unnamed: D5.2 (A), D6.1 (A1), F1.2
unnamed: D8.2 (A), R48.1
unnamed: D9.2 (A), R49.1
unnamed: D10.2 (A), R50.1
unnamed: D11.2 (A), R51.1
unnamed: D12.2 (A), R52.2
unnamed: D13.2 (A), R58.2
unnamed: F1.1, J10.1
unnamed: J2.A5 (CC1), R17.2
unnamed: J2.B5 (CC2), R16.2
unnamed: J3.9, R28.2
unnamed: J3.12, R29.2
unnamed: Q1.1 (B), R10.1, R11.1, R12.2
unnamed: Q1.2 (E), R13.2
unnamed: R7.1, SW2.2 (B)
unnamed: R5.1, R7.2, U1.10 (PA0)
unnamed: R6.2, U1.25 (PB12)
unnamed: R3.1, U1.2 (PC13)
unnamed: R4.1, U1.3 (PC14)
unnamed: C2.1, U1.5 (PD0), Y1.1
unnamed: C3.1, U1.6 (PD1), Y1.2
unnamed: R14.2, U3.94 (BOOT0)
unnamed: C55.2, U3.8 (PC14), Y3.1
unnamed: C54.1, U3.9 (PC15), Y3.2
unnamed: C11.1, U3.49 (VCAP_1)
unnamed: C10.1, U3.73 (VCAP_2)
unnamed: R43.2, U4.6 (CLK)
unnamed: R42.1, U4.7 (~HOLD/~RESET/IO_{3})
unnamed: R41.2, U4.3 (~WP/IO_{2})
unnamed: R22.1, U6.24 (RBIAS)
unnamed: R26.2, U6.10 (RXER/PHYAD0)
unnamed: C24.2, C27.2, U6.6 (VDDCR)
unnamed: C29.2, U6.5 (XTAL1/CLKIN), Y2.1
unnamed: R23.2, U6.14 (~INT/REFCLKO)
unnamed: C41.1, U7.6 (BST)
unnamed: C41.2, L1.1, U7.5 (SW)
unnamed: C42.1, U8.6 (BST)
unnamed: C42.2, L2.1, U8.5 (SW)
unnamed: C62.2, R18.2, S2.C, S2.D, U14.2 (EN)
unnamed: R21.1, U14.16 (IO2)
unnamed: R20.1, U14.7 (IO8)
VBUS: D4.2 (A), J2.A4 (VBUS), J2.A9 (VBUS), J2.B4 (VBUS), J2.B9 (VBUS), R11.2, R58.1, U2.5 (VBUS)

Notes on the sheet:
Flash memory
STLINK - V2
GPIO
SENSOR
RS485
Power - Buck 12V - 5V - 3.3V
ETHERNET - LAN
4 Chanel Relay 12V
WIFI ESP32

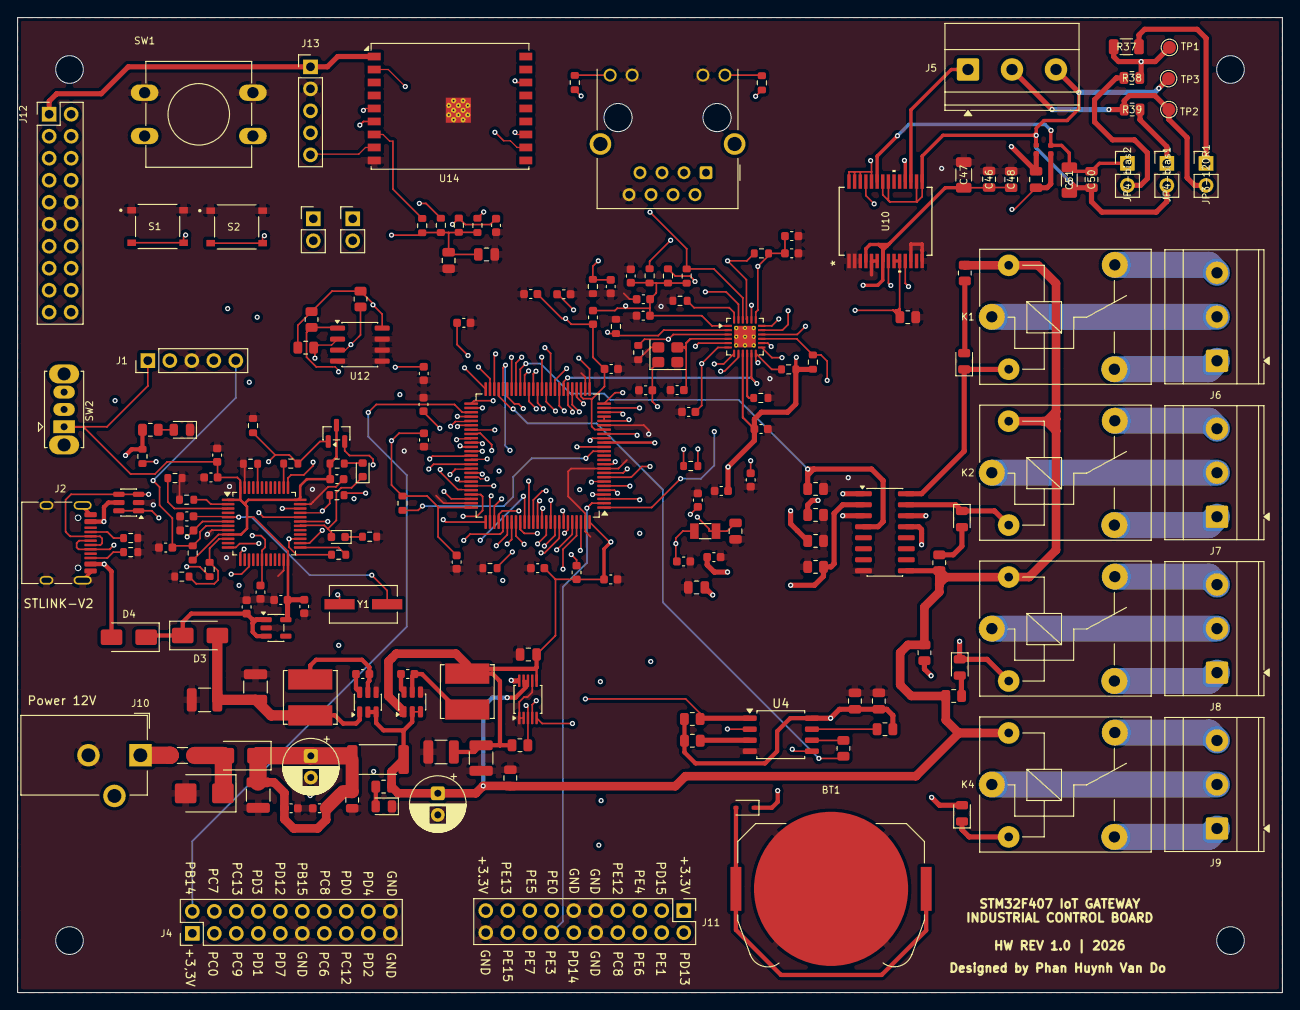
[picture p15: board IoT_gateway_STM32F407.kicad_pcb from above]

Board: 6 copper layers, 146.1 x 112.6 mm, 191 parts (0 on the bottom side), 180 nets.

Other parts of the board:
H1, H2, H3, H4: MountingHole_3.2mm_M3
